shArk1538/ROS_STM32-Car/README.md

# ROS_STM32-Car
**an intelligent car equipped with STM32 board and host computer to SLAM and navigation**

1、AutoDriver存放控制小车的底层STM32工程代码

2、PS2手柄控制协议

3、STM32板的原理图，包括AD

4、串口通讯数据传输协议
