shArk1538/ROS_STM32-Car/AutoDriver/readme.txt

CORE：用来存放核心文件和启动文件
OBJ：存放编译过程文件以及hex文件
STM32F10x_FWLib：存放ST官方提供的库函数源码文件
USER：存放project工程文件，还有main.c以及system_stm32f10x.c
