shArk1538/ROS_STM32-Car/PS2手柄/PS2解码通讯及例程V1.82/PS2例程 - stm32资料/PS2振动实验(KEIL5)/README.TXT

软件版本：keil5

实验实现功能:1、按下手柄按键，串口输出对应键值。
             2、软件设置“红灯模式”、“绿灯模式”，并可以设置“保存”，通过手柄模式按键无法改变。
             3、设置手柄震动：通过数值的设置，改变左侧大震动电机震动频率。
                当按下“L1”时，小震动电机转动，按下“R1”时，大震动电机转动。
实验连接方式：输入  DI->PB12 
              输出  DO->PB13    CS->PB14  CLK->PB15

               YFROBOT
               2015-12-19
               技术售后：QQ：1159041353
	       技术支持论坛：www.yfrobot.com
               淘宝店铺：http://shop73109108.taobao.com
                         http://shop62349362.taobao.com
