shArk1538/ROS_STM32-Car/PS2手柄/PS2解码通讯及例程V1.82/PS2例程 - stm32资料/ps2遥控小车/README.TXT

实验实现功能:PS2手柄实现与balance通讯，通过左摇杆控制小车前进后退，并可进行速度控制，
             通过右侧摇杆，左右推动，控制小车的转弯半径，使小车行驶路径控制无压力。

               YFROBOT
               2015-05-30
               技术售后：QQ：1159041353
	       技术支持论坛：www.yfrobot.com
               购买：http://shop73109108.taobao.com
                     http://shop62349362.taobao.com
