shArk1538/ROS_STM32-Car/底层驱动板PCB/Project Outputs for Driver/Driver.xlsx

Comment | Description | Designator | Footprint | LibRef | Quantity
0.1μF | Capacitor | C1, C3, C6, C8, C9, C11, C12, C16, C18, C20, C21, C22, C26, C27, C28, C29, C30, C31, C32, C33, C35 | 0603C | Cap | 21
1μF | Capacitor | C2, C4, C10, C17, C19, C24, C25 | 0603C | Cap | 7
10μF | Capacitor | C5, C7 | 0603C | Cap | 2
220μF 50V | Capacitor | C13, C14 | CAP-TH_BD10.0-P5.00-D1.0-FD | Cap_A | 2 | 用的是470uF
220μF 16V | Capacitor | C15 | CAP-TH_BD6.3-P2.50-D1.0-FD | Cap_A | 1
100nF | Capacitor | C23 | 0603C | Cap | 1
20nF | Capacitor | C34, C36 | RAD-0.2 | Cap | 2 | 标注错误，用20pF
D-SS12 |  | D1, D2, D3, D4 | SMA_L4.4-W2.6-LS5.0-RD | D-SS12 | 4
LED_0603 |  | D5, D8, D9, D12, D13, D14 | 0603D | LED_0603 | 6
P6KE11A |  | D6, D7 | DO-15_BD3.1-L6.7-P10.70-D0.9-FD | P6KE68A | 2 | 无，用6.8代替
P6KE6.8A |  | D10, D11 | DO-15_BD3.1-L6.7-P10.70-D0.9-FD | P6KE68A | 2
Inductor | Inductor | L1 | 0603L | Inductor | 1
SWITCH36 | Header, 3-Pin | P1 | 船型开关 | Header 3 | 1
SWITCH12 | Header, 3-Pin | P2 | 钮子开关 | Header 3 | 1
SWITCH5 | Header, 3-Pin | P3 | SWITCH_SS-12F44 | Header 3 | 1
IRF3205 |  | Q1, Q2, Q3, Q4, Q5, Q6, Q7, Q8 | TO-262-AA | IRF3205 | 8
10K | Resistor | R1, R2, R3, R4, R7, R8, R9, R10, R14, R15, R16, R17, R18, R19, R20, R21, R23, R24, R25 | 0603R | Res1 | 19
0Ω | Resistor | R5, R6 | 0603R | Res1 | 2
120 | Resistor | R11 | 0603R | Res1 | 1
100R | Resistor | R12, R13 | 0603R | Res1 | 2
1M | Resistor | R22 | 0603R | Res1 | 1
SW_PB | SWITCH | S1 | SMD_6MM*3MM | SW_PB | 1
AS1117-3.3 |  | U1 | SOT223_N | AS1117-3.3 | 1
IR2104S |  | U2, U3, U4, U5 | SO8_N | IR2104S | 4
MAX3485 |  | U6 | SO8_N | MAX3485 | 1
74HC244 |  | U7 | SOIC-20_L13.3-W5.5-P1.27-LS7.8-BL | 74HC244 | 1
stm32f103c8t6 |  | U8 | STM-LQFP48_N | stm32f103c8t6 | 1
CC6904SO |  | U9, U10 | SO8_N | CC6902SO | 2
8MHz | Crystal | X1 | HC-49US_L11.5-W4.5-P4.88 | 8MHz | 1
