shArk1538/ROS_STM32-Car/(list of files, cad)

Other CAD files:
PS2手柄/PS2解码通讯及例程V1.82/PS2-51例程/PS2—STC12C5A60S2/STARTUP.OBJ
