shArk1538/ROS_STM32-Car/底层驱动板PCB/Driver.pdf

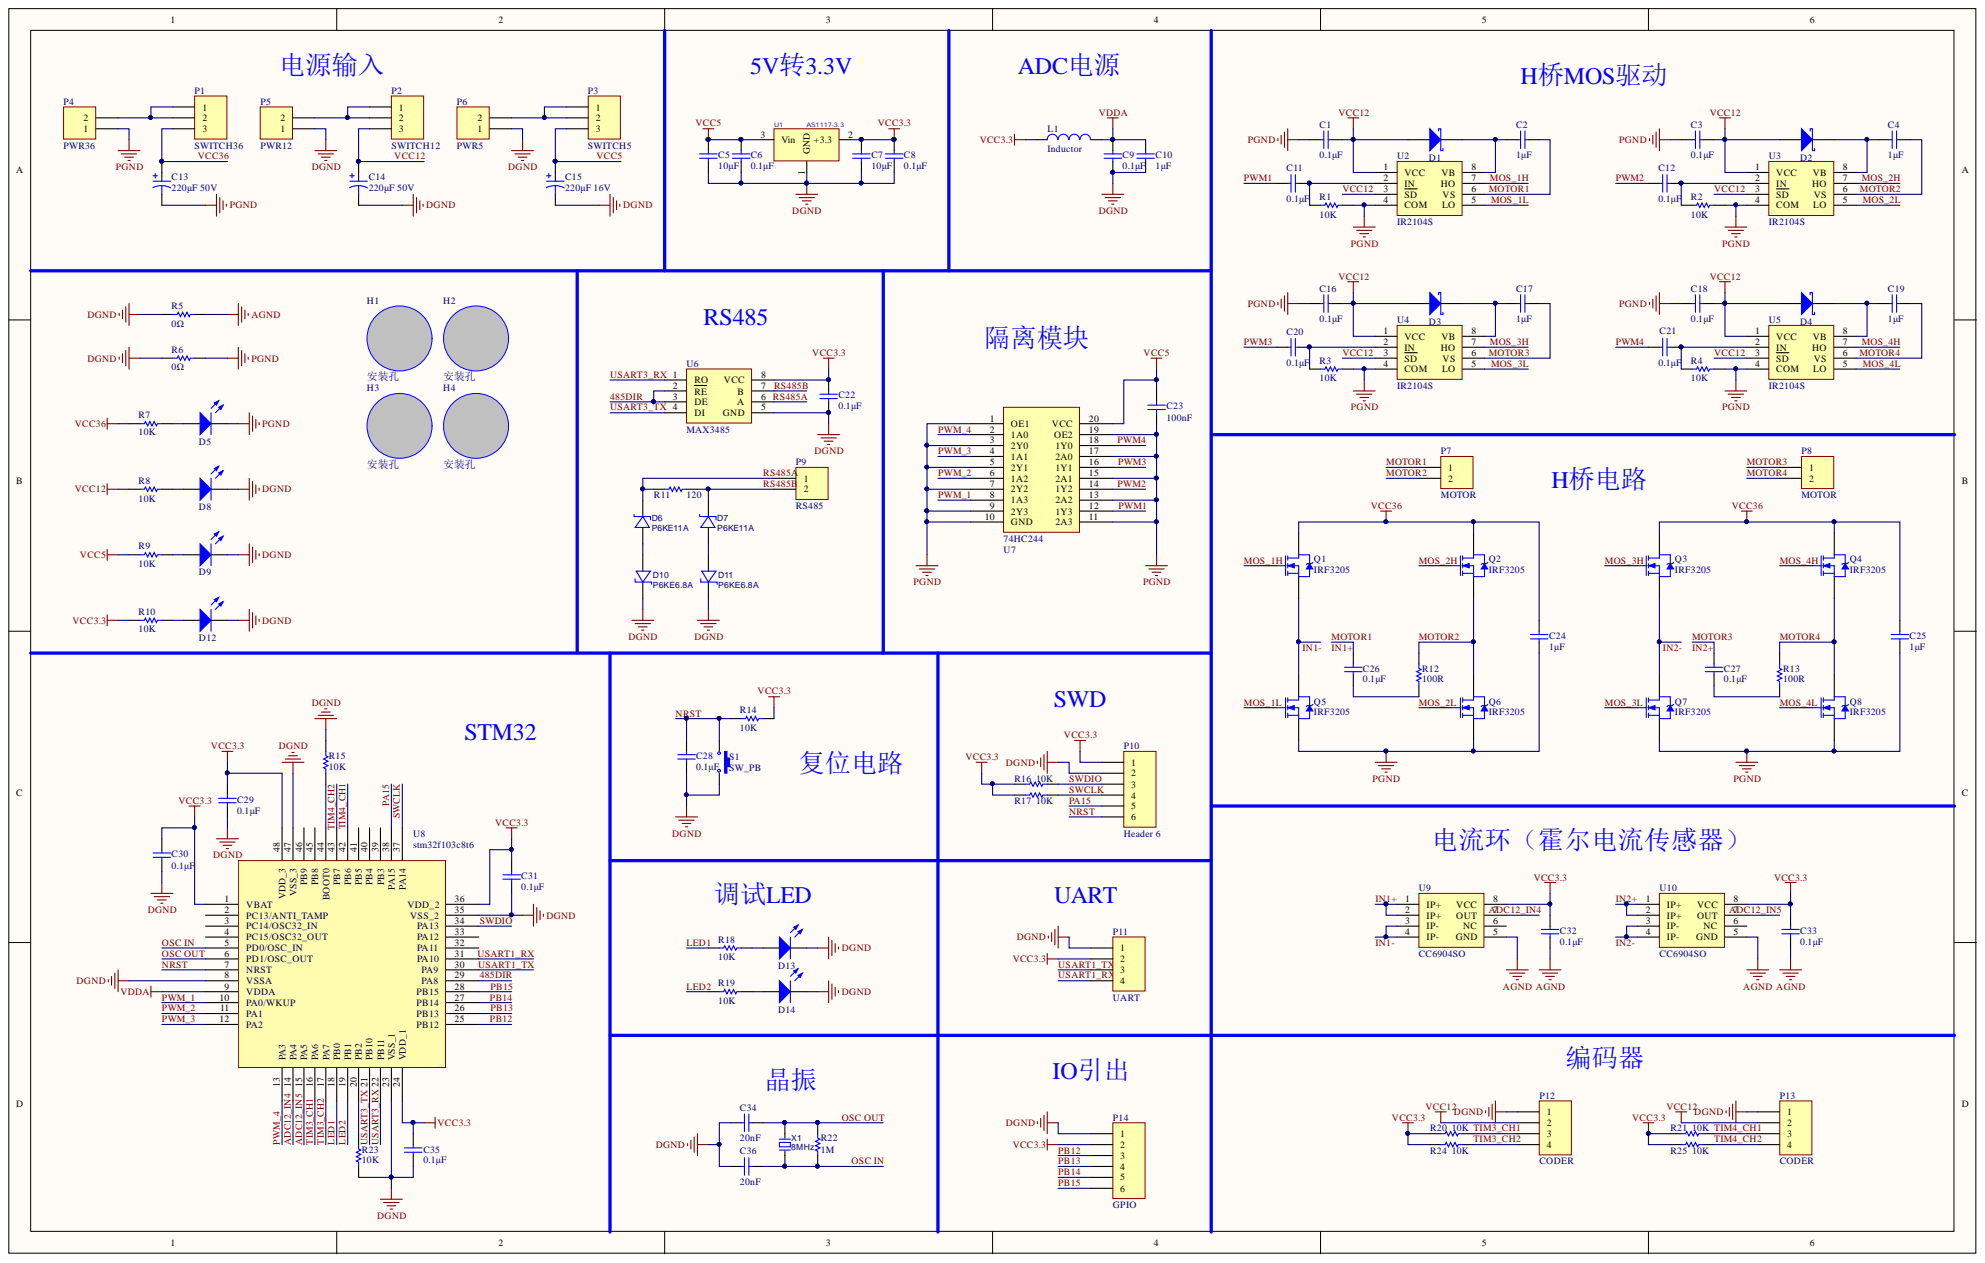
[picture p3: page 1]
