shArk1538/ROS_STM32-Car/(list of files, drawings)

Other design files:
底层驱动板PCB/AD to Gerber/Driver_3/Driver_3.PcbDoc
底层驱动板PCB/Driver.PcbDoc
底层驱动板PCB/Driver.PcbLib
底层驱动板PCB/Driver.PrjPCB
底层驱动板PCB/Driver.SchDoc
底层驱动板PCB/Driver.SchLib
底层驱动板PCB/Driver_1.PcbDoc
底层驱动板PCB/Driver_2.PcbDoc
底层驱动板PCB/Driver_3.PcbDoc
