shArk1538/ROS_STM32-Car/PS2手柄/PS2解码通讯及例程V1.82/PS2-51例程/PS2—STC12C5A60S2/main.c

#include <STC12C5A.H>  
#include <stdio.h>
#include <absacc.h>
#include <intrins.h>
/*********************************************************
Copyright (C), 2015-2025, ZYRobot.
湖南智宇科教设备有限公司
www.hnzhiyu.cn
File：ps2测试程序
Author：zhulin    Version:1.0     Data:2017/05/30

**********************************************************/	 

#define  Fosc  22118400     //晶振频率

#define uchar unsigned char
#define uint unsigned int

sbit  Speaker=P1^1;
sbit  Led=P1^0;

sbit  DATA=P3^4;	//手柄接口
sbit  CMND=P3^5;
sbit  ATT=P3^6;
sbit  CLK=P3^7;

/********手柄定义变量*********/
uchar code scan[9]={0x01,0x42,0x00,0x00,0x00,0x00,0x00,0x00,0x00};
uchar  out[9];  
/********************************************************************
* 名称 : void delayms(uint xms)
* 功能 : 延时
* 输入 : 有
* 输出 : 无
***********************************************************************/
void delayms(uint xms)
 {
   uint i,j;
   for(i=xms;i>0;i--)
      for(j=1700;j>0;j--);
 }
/********************************************************************
* 名称 : void uart_init()
* 功能 : 串口设置
* 输入 : 无
* 输出 : 无
***********************************************************************/
void uart_init()
{
	SCON=0x50;//8位发送，无奇偶校验位
	BRT=0xfa;//BRT=256-Fosc/32/9600/12;
	AUXR=0x91;//选择并打开独立计数器
    EA=1; // 打开总中断开关
    ES=1; // 打开串口中断开关 
}
/********************************************************************
* 名称 : uart_sendata(uchar n)
* 功能 : 发送字节
* 输入 : 有
* 输出 : 无
***********************************************************************/
void uart_sendata(uchar n)
{	
    ES=0;
	TI=0;
    SBUF = n;
	while(!TI);                   //如果发送完毕，硬件会置位TI
	TI=0;
	ES=1;				
}

void delay(uint n)  //delay(x)=(2.5+x)us; 
{
	uint i;
	for(i=0;i<n;i++) _nop_();       
//		_nop_();//每个_nop_();大概0.1微秒	
}
void psin(uchar command)//手柄发送子程序
{
    uchar i;
    for(i=0;i<=7;i++)     //逐位接收     
    {
	 if(command&0x01)	 //此if下5行语句用时1us
        CMND=1;
     else
        CMND=0;
     command=command>>1;
	 	_nop_();	
		_nop_();
     CLK=0;
     delay(10); 
     CLK=1;
	 delay(3);
    }
	CMND=1;
}
uchar scanout(uchar command)//手柄发送子程序
{
    uchar i,j=1;
	uchar res=0; 
    for(i=0;i<=7;i++)     //逐位接收     
    {
	 if(command&0x01)
        CMND=1;
     else
        CMND=0;
     command=command>>1;
	 	_nop_();	
		_nop_();
     CLK=0;
     delay(10);
	 if(DATA) res=res+j;
     j=j<<1; 
	 CLK=1;
	 delay(3);		 
    }
    CMND=1;
    return res;	
}
 void Read_PS2(void)//手柄读取程序
{
	 uchar i;
     ATT=0;
	 for(i=0;i<9;i++)	//扫描按键
        {
         out[i]=scanout(scan[i]);	
		 } 
     ATT=1;	    	 
   	 for(i=0;i<9;i++)
        {
		 uart_sendata(0x30);
		 uart_sendata(0x78);
		 if(out[i]/16<10) uart_sendata(out[i]/16+0x30);
		 else uart_sendata(out[i]/16+0x37);
		 if(out[i]%16<10) uart_sendata(out[i]%16+0x30);
		 else uart_sendata(out[i]%16+0x37);
         uart_sendata(' ');
		 uart_sendata(' ');
		}
	uart_sendata(0x0d);
    uart_sendata(0x0a);		  
} 	 	 	 	 	 
void main()
{ 
	delayms(500);

    Speaker=0;
    Led=1;

	P4SW=0x70;	 //P4口特殊声明
	uart_init();

while(1)
	 {

	 Read_PS2(); 
	 delayms(500);
	}

} 

/*****************************PS2遥控器说明
out[3]==0xEF//左4个按键中上
out[3]==0xBF//左4个按键中下
out[3]==0x7F//左4个按键中左
out[3]==0xDF//左4个按键中右

out[4]==0xEF//右4个按键中上
out[4]==0xBF//右4个按键中下
out[4]==0x7F//右4个按键中左
out[4]==0xDF//右4个按键中右

out[4]==0xFB//左1,2个按键中1
out[4]==0xFE//左1,2个按键中2
out[4]==0xF7//右1,2个按键中1
out[4]==0xFD//右1,2个按键中2

当按下MODE键手柄MODE LED灯亮起时
out[7] 00——80——FF 左摇杆从左到右
out[8] 00——7F——FF 左摇杆从上到下
out[5] 00——80——FF 右摇杆从左到右
out[6] 00——7F——FF 右摇杆从上到下
当手柄MODE LED灯不亮时，手柄功能同左四右四按键
*******************************/
