shArk1538/ROS_STM32-Car/AutoDriver/HARDWARE/INCLUDE.h

#ifndef __INCLUDE_H
#define __INCLUDE_H	
#include "stm32f10x.h"
#include "delay.h"
#include "sys.h"
#include "usart.h"

////////////////////////////////////////////////////////////////////////


//						硬件部分头文件包含


////////////////////////////////////////////////////////////////////////

#include "INIT.h"
#include "LED.h"
#include "PWM.h"
#include "ADC.h"
#include "CODER.h"
#include "TIMER.h"
#include "PSTWO.h"

////////////////////////////////////////////////////////////////////////


//						控制算法部分头文件包含


////////////////////////////////////////////////////////////////////////

#include "PID.h"
#include "Parameter.h"

#endif
