shArk1538/ROS_STM32-Car/AutoDriver/HARDWARE/INIT.h

#ifndef __INIT_H
#define __INIT_H
#include "INCLUDE.h"

////////////////////////////////////////////////////////////////////////


//						总硬件初始化


////////////////////////////////////////////////////////////////////////

void HARDWARE_Init(void);

#endif
