shArk1538/ROS_STM32-Car/AutoDriver/HARDWARE/LED.h

#ifndef __LED_H
#define __LED_H
#include "INCLUDE.h"

////////////////////////////////////////////////////////////////////////


//					D13: LED1->PB0 ; D14: LED2->PB1
//					LED初始化、亮灭


////////////////////////////////////////////////////////////////////////

#define LED1 PBout(0)
#define LED2 PBout(1)

void LED_Init(void);

#endif
