shArk1538/ROS_STM32-Car/AutoDriver/HARDWARE/TIMER.h

#ifndef __TIMER_H
#define __TIMER_H
#include "INCLUDE.h"

////////////////////////////////////////////////////////////////////////


//					由定时器1定时产生中断
//					用于周期性采集并进行控制


////////////////////////////////////////////////////////////////////////

#define TIMER_TIMx 					TIM1
#define TIMER_TIMx_APBxClock_FUN	RCC_APB2PeriphClockCmd
#define TIMER_TIMx_CLK				RCC_APB2Periph_TIM1

#define TIMER_ARR					49
#define TIMER_PSC					7200

#define TIMER_IT_IRQn				TIM1_UP_IRQn

void TIMER_TIMx_Config(void);

#endif
